Normansrule/luxor-watch/docs/images/exploded_ivory.png

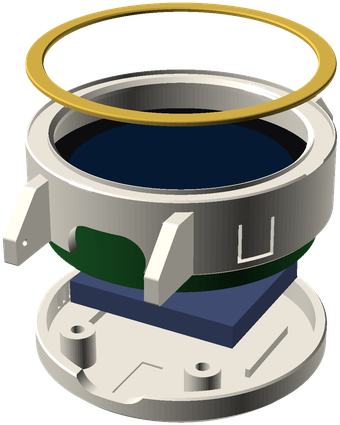
docs/images/exploded_ivory.png
