Normansrule/luxor-watch/docs/images/screens_ivory.png

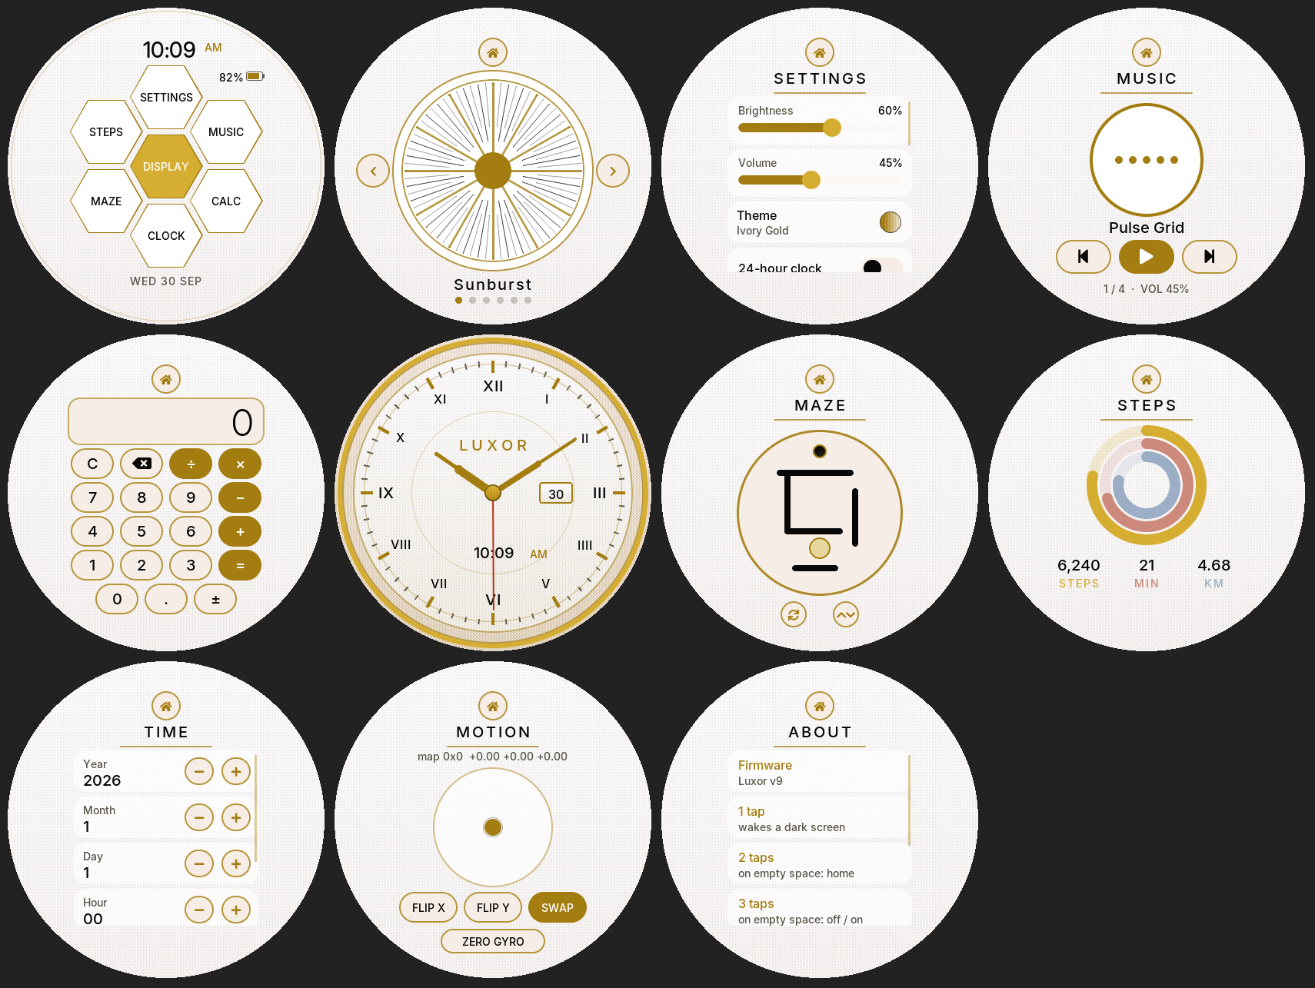
docs/images/screens_ivory.png
