Normansrule/luxor-watch/docs/images/screens_noir.png

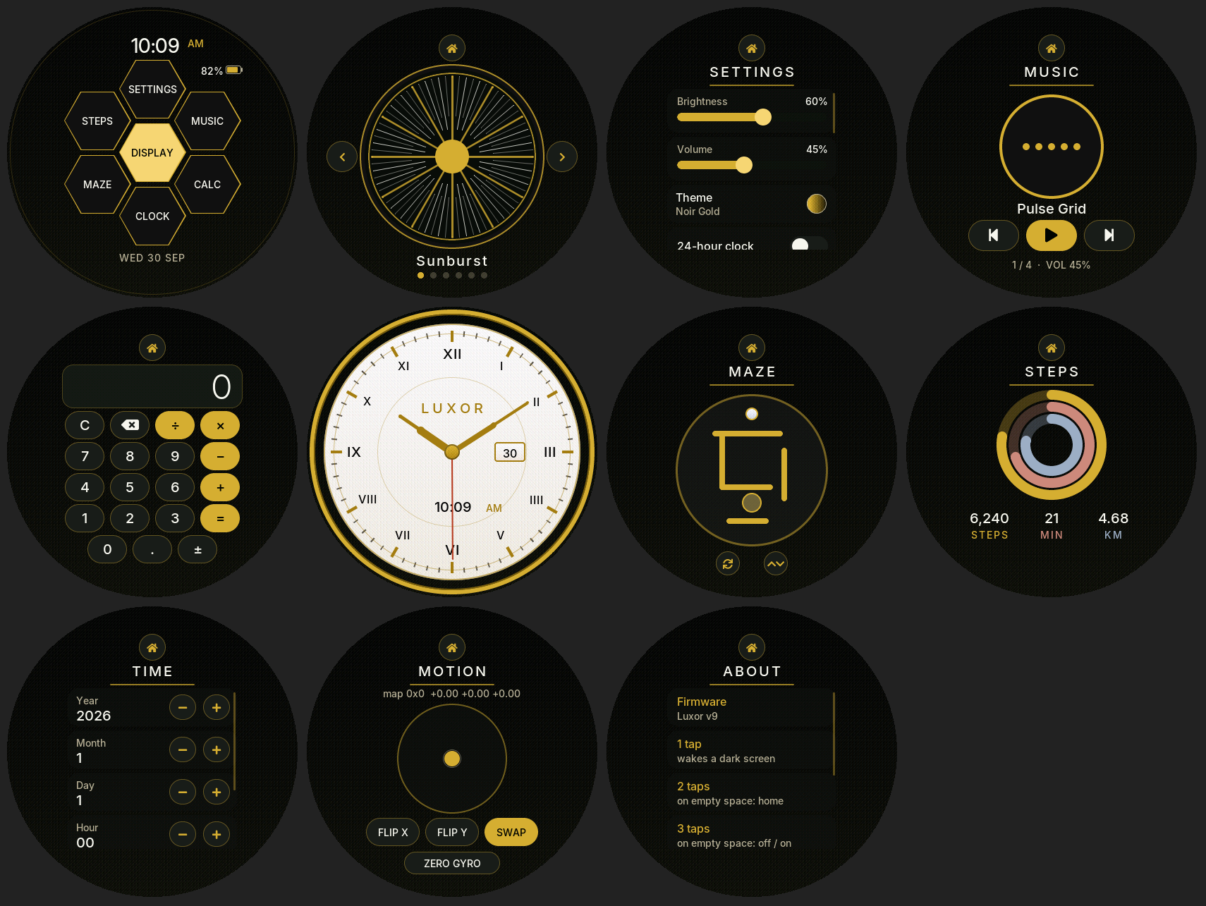
docs/images/screens_noir.png
