Normansrule/luxor-watch/hardware/renders/back.png

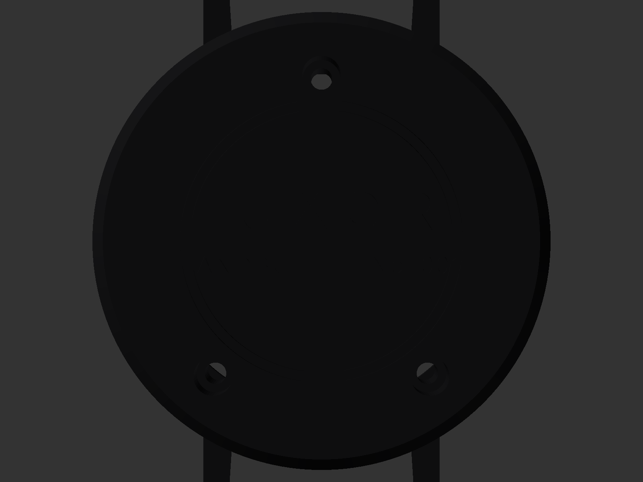
hardware/renders/back.png
