Normansrule/luxor-watch/hardware/renders/dock.png

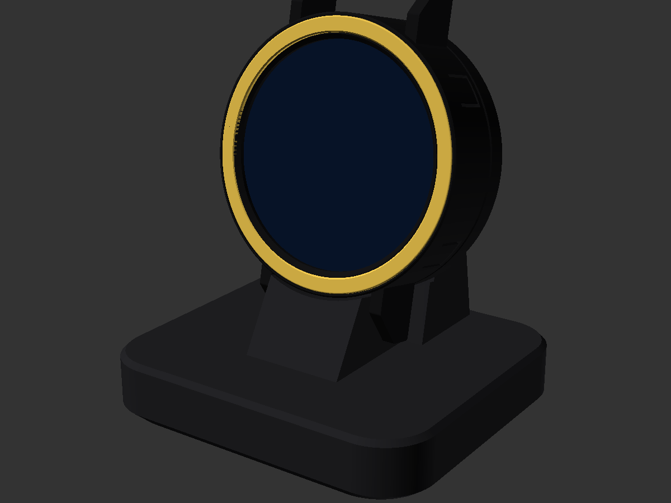
hardware/renders/dock.png
