Normansrule/luxor-watch/hardware/renders/exploded.png

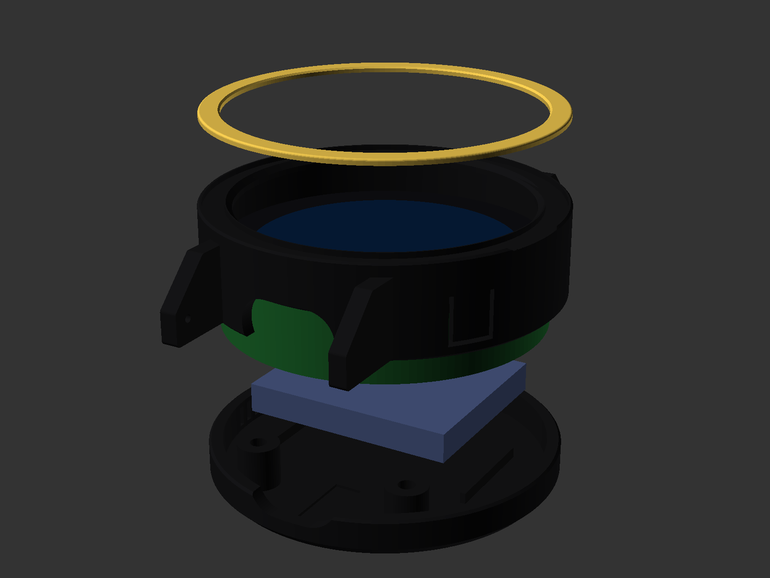
hardware/renders/exploded.png
