Normansrule/luxor-watch/hardware/renders/hero_ivory.png

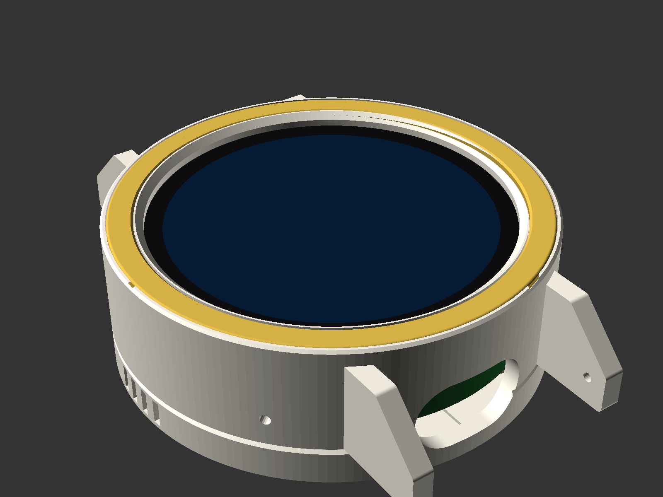
hardware/renders/hero_ivory.png
