Normansrule/luxor-watch/hardware/renders/section.png

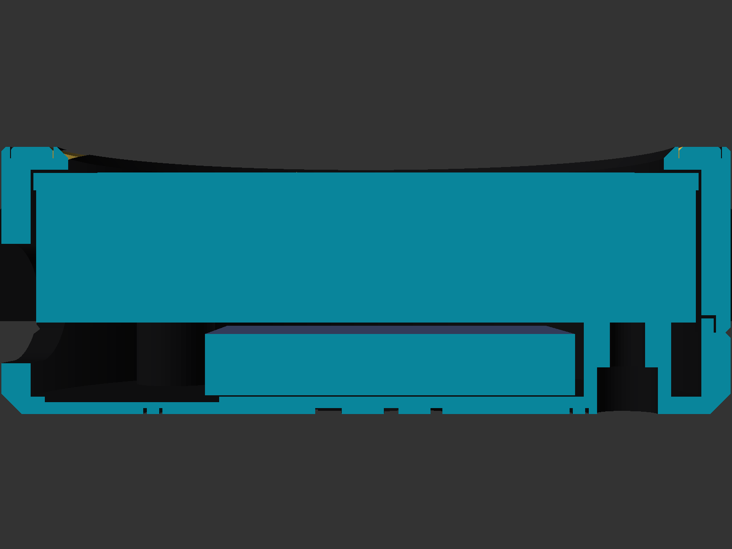
hardware/renders/section.png
