Normansrule/luxor-watch/hardware/stl/coupon_A.stl

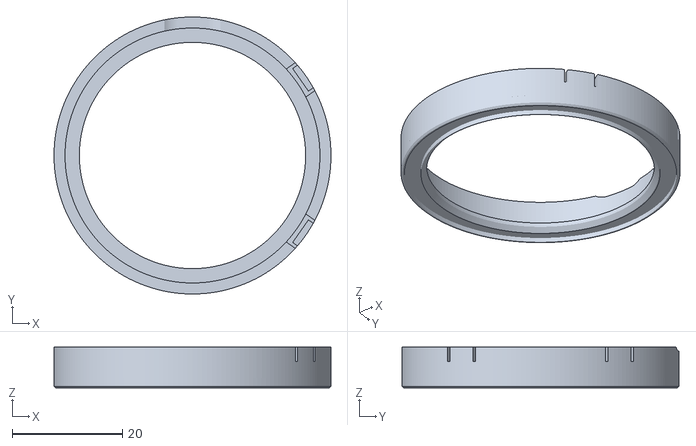
[picture p13: CAD file, 2026-10-02]
hardware/stl/coupon_A.stl
50.2 x 50.2 x 7.40
