Normansrule/luxor-watch/hardware/stl/coupon_B.stl

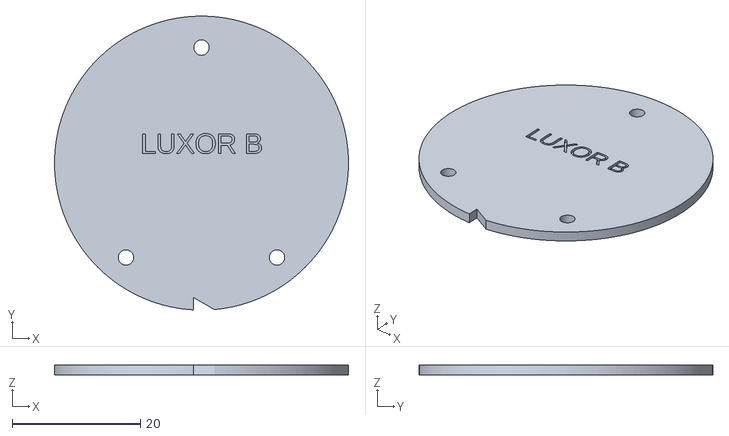
[picture p14: CAD file, 2026-10-02]
hardware/stl/coupon_B.stl
45.8 x 45.8 x 1.60
