Normansrule/luxor-watch/hardware/stl/coupon_C.stl

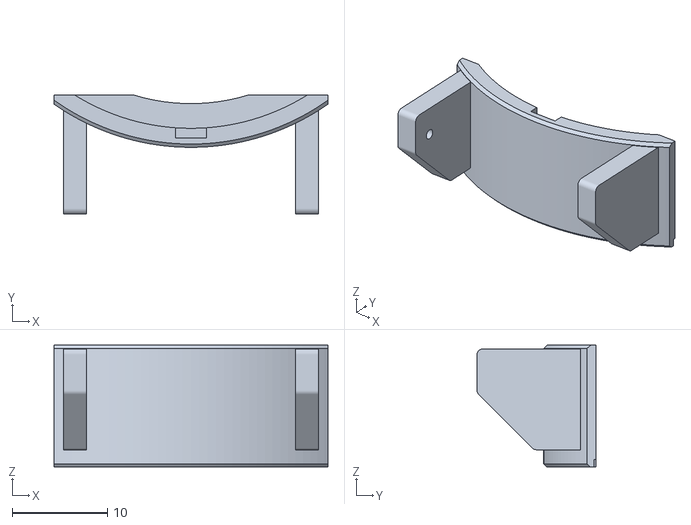
[picture p15: CAD file, 2026-10-02]
hardware/stl/coupon_C.stl
28.8 x 12.5 x 12.8
