Normansrule/luxor-watch/hardware/stl/02_back_cover.stl

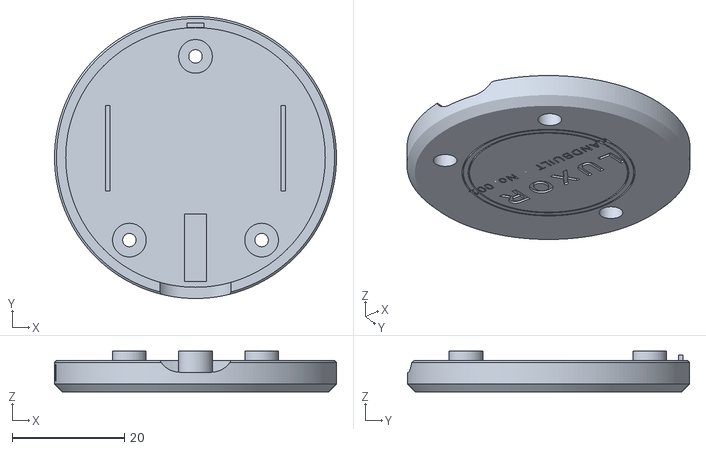
[picture p16: CAD file, 2026-10-02]
hardware/stl/02_back_cover.stl
50.2 x 50.2 x 7.27
