Normansrule/luxor-watch/hardware/stl/03_bezel_ring.stl

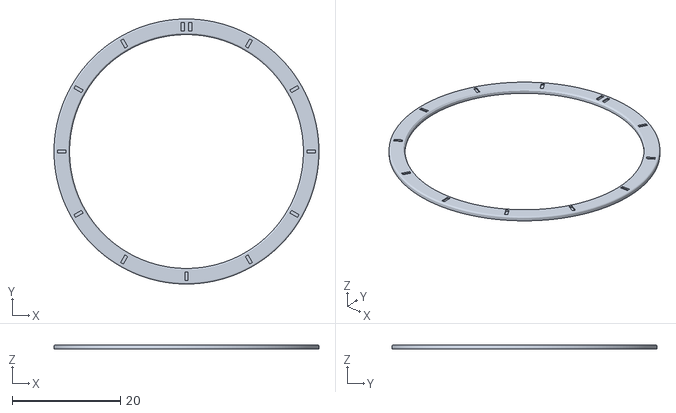
[picture p17: CAD file, 2026-10-02]
hardware/stl/03_bezel_ring.stl
48.9 x 48.9 x 0.8
