Normansrule/luxor-watch/hardware/stl/04_charging_dock.stl

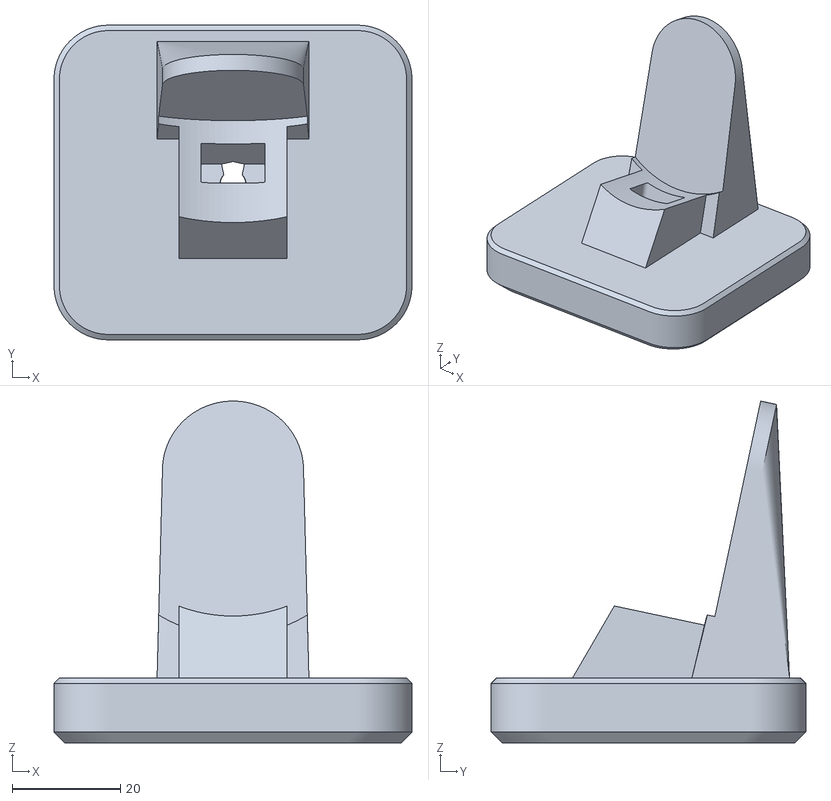
[picture p18: CAD file, 2026-10-02]
hardware/stl/04_charging_dock.stl
66.0 x 58.0 x 63.0
