Normansrule/luxor-watch/hardware/stl/01_case_shell.stl

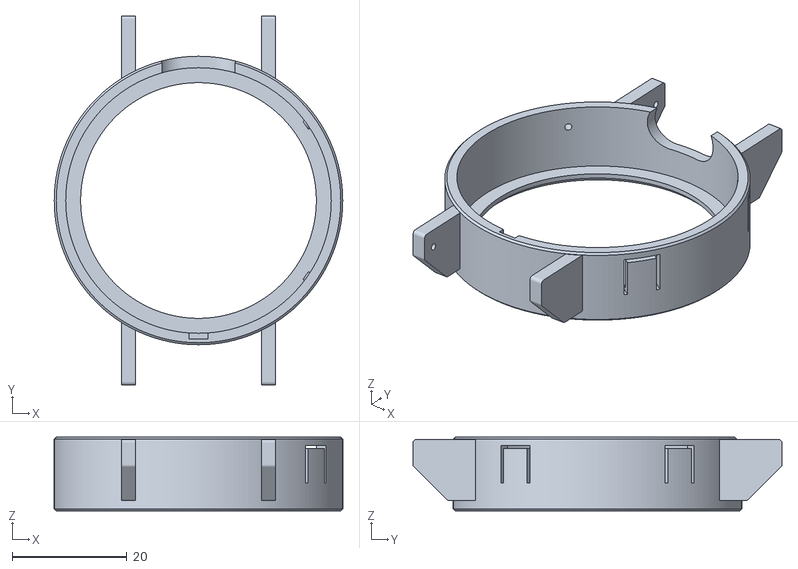
[picture p19: CAD file, 2026-10-02]
hardware/stl/01_case_shell.stl
50.2 x 64.2 x 12.8
