Normansrule/luxor-watch/hardware/parts/04_charging_dock.scad

// Part 4 — upright charging dock.  The USB-C plug sits pointing up in a pocket;
// unclip the lower strap half and lower the watch onto it.
// PRINT: base-down as exported.  Any colour; 0.2 mm; 3 walls; 20 % infill.
// Optional: glue M8 steel washers (16 mm OD) or 15 mm rubber feet into the two pockets underneath.
include <../luxor_lib.scad>
dock();
