Normansrule/luxor-watch/main/version.h

#pragma once
/* Shown in the boot log, on the About screen and at the bottom of Settings,
 * so you can always see which build is actually running on the watch.
 * Bumped for every package; the zip and its folder carry the same name. */
#define LUXOR_FW_VERSION "v9"
