Normansrule/luxor-watch/(notices)

Notices in the files:
README.md:
License: MIT
